zerobline/fraction-collector/docs/PARTS.md

# Parts list — compatible rack and glassware

This page is designed to help a new builder find the correct components quickly. **No affiliation or endorsement** by the referenced suppliers.

| Qty | Part | Reference | Purchase link |
|---:|---|---|---|
| 1 | Single-row, clear acrylic test-tube rack | **Tuuters E51016** — 10 holes, Ø16.5 mm; 280 × 70 × 84 mm | [Official rack](https://www.tuuters.de/reagenzglashalter/aus-acryl/acrylhalter-ohne/10-loch-acryl-reagenzglashalter-16-in-einer-reihe.html) |
| 10 | Glass round-bottom tubes, smooth rim, no stopper | 120 mm long × Ø16 mm outside; nominal Ø14.4 mm inside, approx. 16 mL | [Official tubes](https://www.tuuters.de/reagenzglaeser/reagenzglaeser-ohne.html) — select **120 × Ø16**, **without closure** |
| 1 | Funnel strip | Use native FreeCAD design from `cad/`; 10 × 27 mm center pitch | [Design dimensions](DESIGN.md) |
| Optional | Stoppers/caps | Order separately if storage is needed; **do not operate with sealed tubes** | Check fit and medium compatibility |

### Supplier nomenclature

- German: **Reagenzglashalter**, **10-Loch Acryl**, **Ø16,5 Einreiher**, **Reagenzglas 120 × Ø16 mm**, **ohne Verschluss**.
- English: *10-position acrylic test-tube rack*, *16 mm OD × 120 mm glass test tubes*, *smooth rim*, *single row*.
- The original purchase screenshot identified the 100-pack of 120 × Ø16 mm tubes as **32161**, but the current product page uses configurable variants; verify the SKU at checkout rather than using it as the sole identifier.

### Substitutes

A substitute rack must have **10 equally spaced centers at 27 mm** (or you must change the CAD pitch), enough clearance for its full-length strip, and the right assembled elevation. A substitute tube must be **Ø16 mm outside** with enough internal clearance for a **Ø13.8 mm locating sleeve** and an appropriate rim for a **Ø17 mm shoulder**.

Do **not** substitute the visually similar 160 × 16 mm tube without checking total installed height; the rack is often sold bundled with that longer tube size.

### Compatibility checklist

- [ ] Rack row: 10 holes in one line
- [ ] Rack hole center pitch measured; expected ~27 mm
- [ ] Each rack hole allows Ø16 mm tubes
- [ ] Actual tube mouth I.D. clears Ø13.8 mm insertion sleeve, including tolerances
- [ ] Ø17 mm shoulder contacts the rim without rocking or interference
- [ ] Tube/rack assembly fits the available vertical space
- [ ] Printing material and cleaning method are appropriate to the actual fluid
