zerobline/fraction-collector/cad/FunnelStrip_Parametric.FCStd

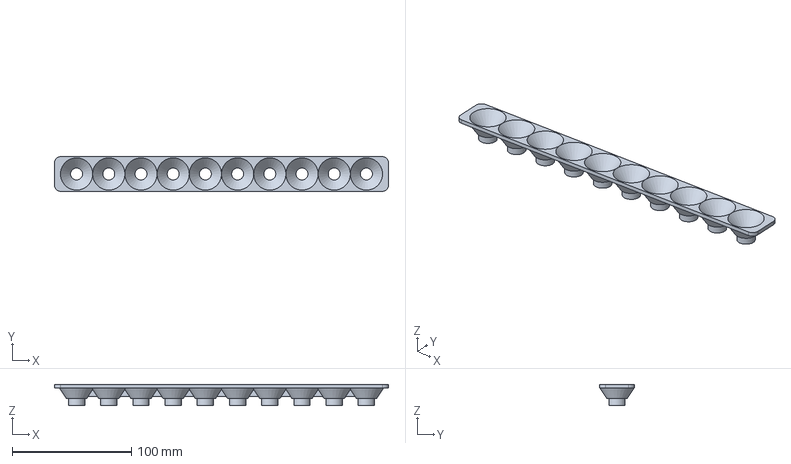
[picture p2: CAD file, 2026-10-28]
cad/FunnelStrip_Parametric.FCStd
280.0 x 29.0 x 18.0 mm
