zerobline/fraction-collector/(list of files, cad)

Other CAD files:
cad/FunnelStrip_Final.step
cad/FunnelStrip_Final.stl
