zerobline/fraction-collector/cad/FunnelStrip_Drawing.pdf

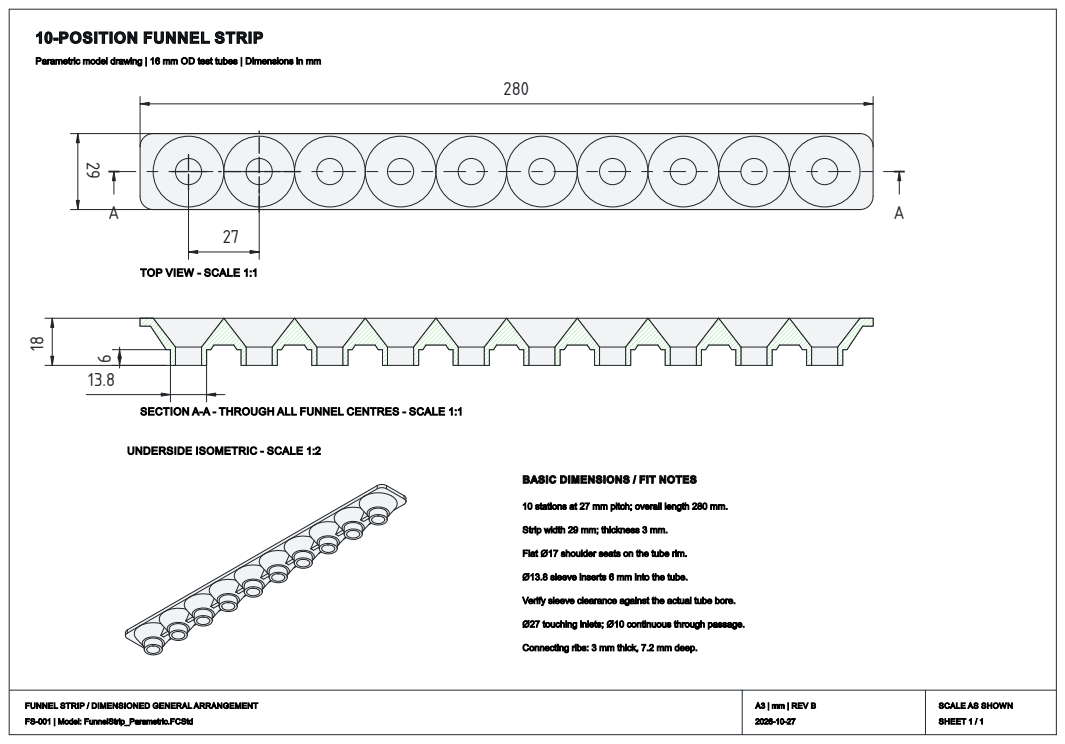
[picture p3: page 1]
